0x007E/osr/README.md

  

# `OSR` - Output Shift Register Development Board

The `OSR` is a board with an [HEF4094B](#additional-information) or any other compatible shift-register that meets the pin requirements. The board itself can be driven from `5` to `15V`. The board offers the possibility to shift serial signals to a parallel output clocked by buttons or an external signal from any other logic board.

| Experience  | Level |
|:---|:---:|
| Soldering | ?% |

# Downloads

| Type | File | Description |
|:---:|:---:|:---|
| Schematic | [pdf](https://github.com/0x007E/osr/releases/latest/download/schematic.pdf) / [cadlab](https://cadlab.io/project/30669/main/files) | Schematic files |
| Board | [pdf](https://github.com/0x007E/osr/releases/latest/download/pcb.pdf) / [cadlab](https://cadlab.io/project/30669/main/files) | Board file |
| Drill | [pdf](https://github.com/0x007E/osr/releases/latest/download/drill.pdf) | Drill file |
| BoM | [xlsx](https://github.com/0x007E/osr/releases/latest/download/bom.xlsx) / [html](https://github.com/0x007E/osr/releases/latest/download/bom.html) | Bill of Material as Excel/interactive HTML |
| PCB | [zip](https://github.com/0x007E/osr/releases/latest/download/kicad.zip) / [tar](https://github.com/0x007E/osr/releases/latest/download/kicad.tar.gz) | KiCAD/Gerber/BoM/Drill files |
| Mechanical | [zip](https://github.com/0x007E/osr/releases/latest/download/freecad.zip) / [tar](https://github.com/0x007E/osr/releases/latest/download/freecad.tar.gz) | FreeCAD/Housing and PCB (STEP/STL) files |

# Hardware

The pcb is created with `KiCAD`. All files are built with `github actions` so that they are ready for a production environment.

## PCB

The circuit board is populated on both sides (Top, Bottom). The best way for soldering the `SMD` components is within a vapor phase soldering system and for the `THT` components with a standard soldering system.

### Top Layer

Top Layer

### Bottom Layer

Bottom Layer

# Additional Information

| Type | Link | Description |
|:---:|:---:|:---|
| HEF4094B | [pdf](https://assets.nexperia.com/documents/data-sheet/HEF4094B.pdf) | 8-stage shift-and-store register |

---

R. GAECHTER
