0x007E/osr/pcb/OSR.kicad_pcb

## KiCad design pcb/OSR.kicad_pcb (2026-11-05)

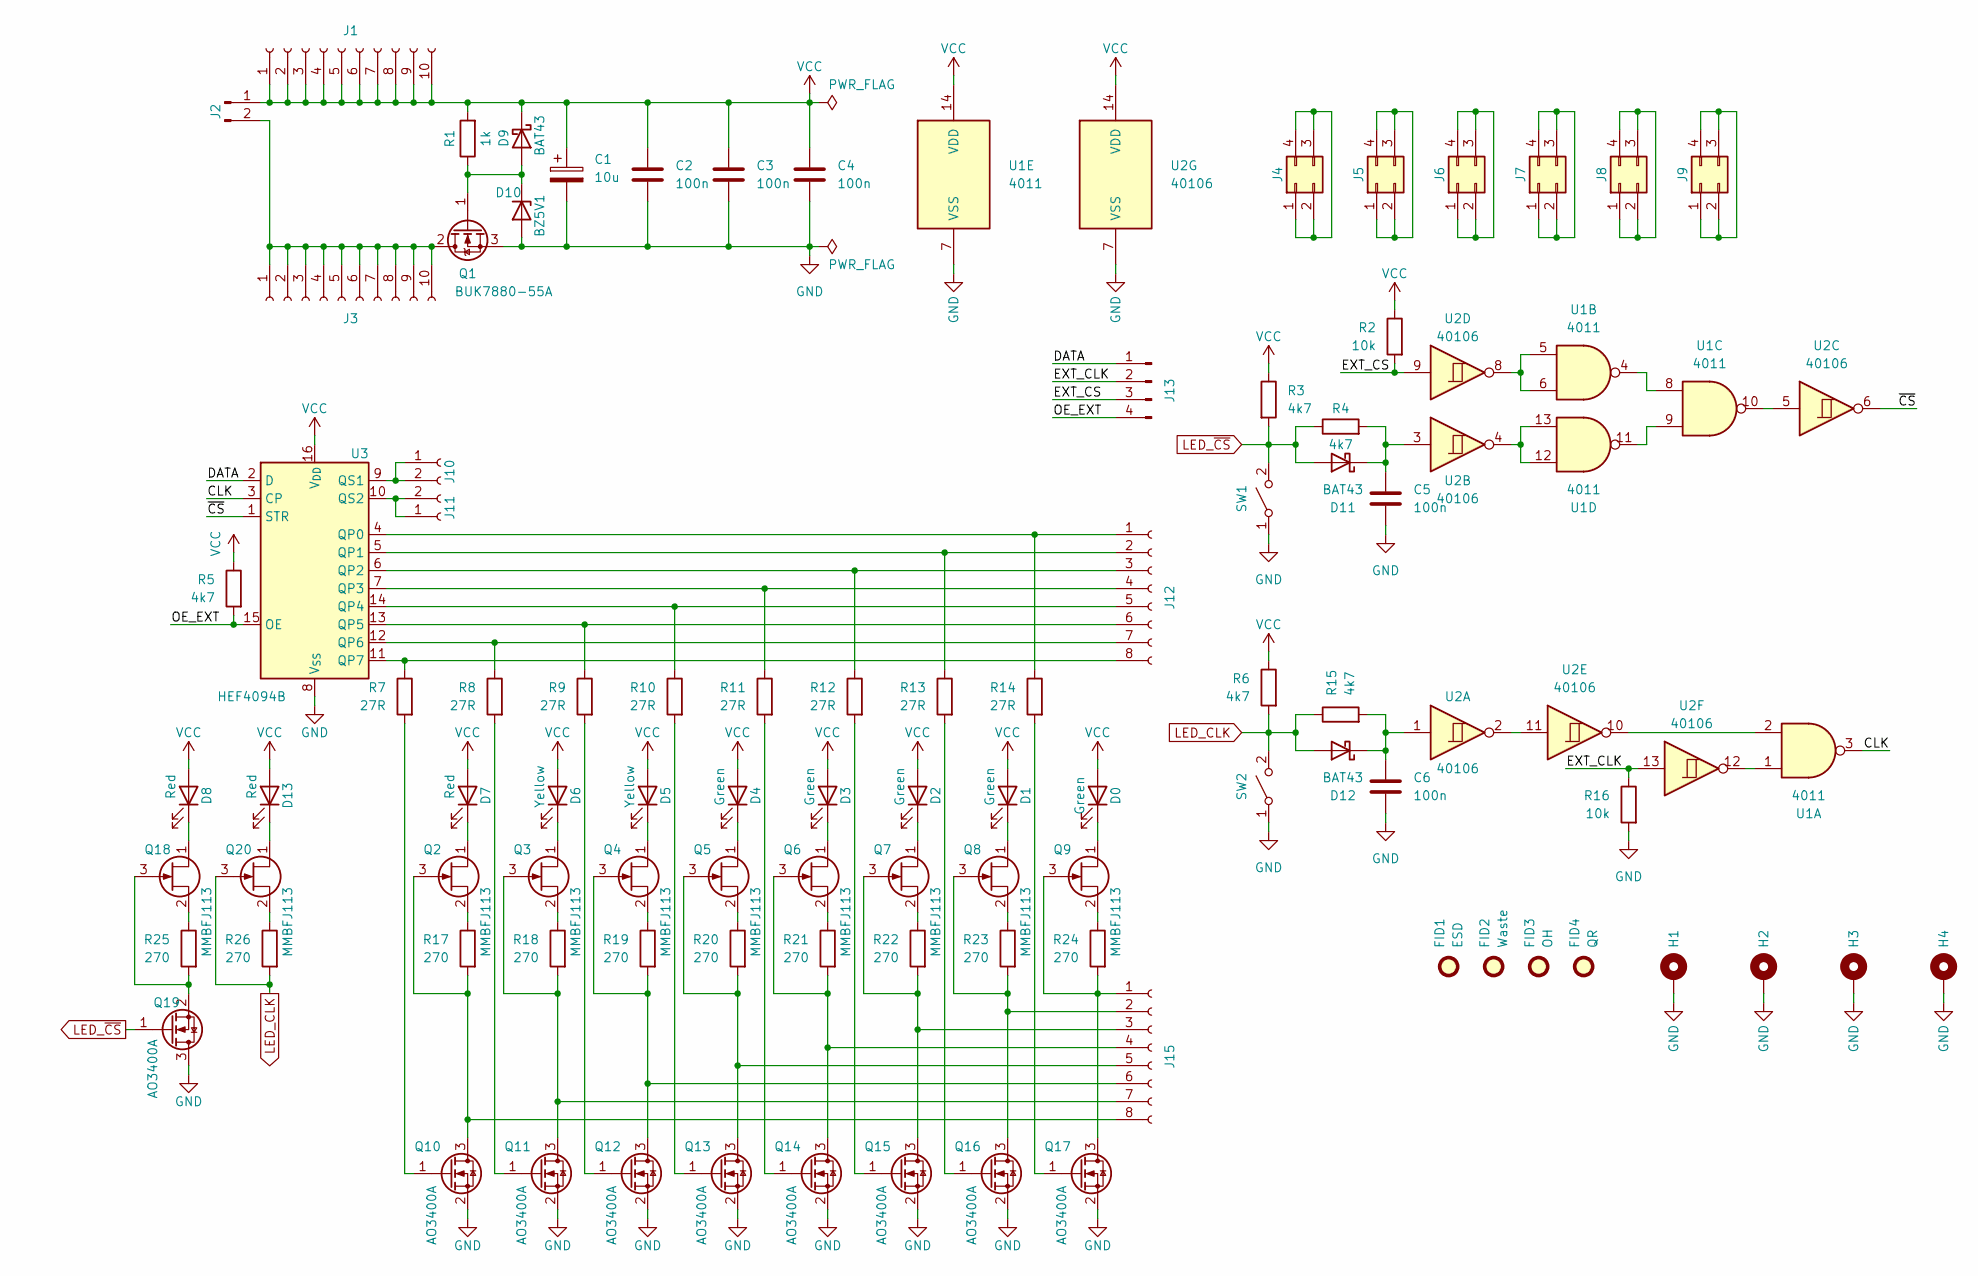
[picture p1: schematic OSR.kicad_sch, ${acronym} - ${title}]

Parts:
C1: 10u; CP_Radial_D6.3mm_P2.50mm
C2, C3, C4, C5, C6: 100n; C_1206_3216Metric
D0, D1, D2, D3, D4: Green; LED_1206_3216Metric
D5, D6: Yellow; LED_1206_3216Metric
D7, D8, D13: Red; LED_1206_3216Metric
D9, D11, D12: BAT43; D_MiniMELF
D10: BZ5V1; D_MiniMELF
FID1: ESD; ESD-Logo_6.6x6mm_SilkScreen
FID2: Waste; WEEE-Logo_4.2x6mm_SilkScreen
FID3: OH; OSHW-Logo_5.7x6mm_SilkScreen
FID4: QR; QR_0x007e
H1, H2, H3, H4: MountingHole_Pad; MountingHole_3.2mm_M3_Pad
J1, J3: Conn_01x10_Socket; PinSocket_1x10_P2.54mm_Vertical; DigiKey 2057-RS1-10-G-ND
J2: Conn_01x02_Pin; PinHeader_1x02_P2.54mm_Vertical
J4, J5, J6, J7, J8, J9: Conn_02x02_Counter_Clockwise; PinSocket_2x02_P2.54mm_Vertical; DigiKey 2057-RS2-04-G-ND
J10, J11: Conn_01x02_Socket; PinSocket_1x02_P2.54mm_Vertical; DigiKey 2057-RS1-02-G-ND
J12, J15: Conn_01x08_Socket; PinSocket_1x08_P2.54mm_Vertical; DigiKey 2057-RS1-08-G-ND
J13: Conn_01x04_Pin; PinHeader_1x04_P2.54mm_Vertical
Q1: BUK7880-55A; SOT-223-3_TabPin2
Q2, Q3, Q4, Q5, Q6, Q7, Q8, Q9, Q18, Q20: MMBFJ113; SOT-23; DigiKey MMBFJ113CT-ND
Q10, Q11, Q12, Q13, Q14, Q15, Q16, Q17, Q19: AO3400A; SOT-23-3
R1: 1k; R_1206_3216Metric
R2, R16: 10k; R_1206_3216Metric
R3, R4, R5, R6, R15: 4k7; R_1206_3216Metric
R7, R8, R9, R10, R11, R12, R13, R14: 27R; R_1206_3216Metric
R17, R18, R19, R20, R21, R22, R23, R24, R25, R26: 270; R_1206_3216Metric
SW1, SW2: SW_SPST; SW_SPST_PTS645
U1: 4011; SOIC-14_3.9x8.7mm_P1.27mm
U2: 40106; SOIC-14_3.9x8.7mm_P1.27mm; DigiKey 296-14081-1-ND
U3: HEF4094B; SOIC-16_3.9x9.9mm_P1.27mm; DigiKey 1727-3062-1-ND

Connections:
/CLK: U1.3, U3.3 (CP)
/DATA: J13.1, U3.2 (D)
/EXT_CLK: J13.2, R16.1, U2.13
/EXT_CS: J13.3, R2.2, U2.9
/OE_EXT: J13.4, R5.2, U3.15 (OE)
/~CS: U2.6, U3.1 (STR)
GND: C1.2, C2.2, C3.2, C4.2, C5.2, C6.2, D10.2 (A), H1.1, H2.1, H3.1, H4.1, Q1.3 (S), Q10.2 (S), Q11.2 (S), Q12.2 (S), Q13.2 (S), Q14.2 (S), Q15.2 (S), Q16.2 (S), Q17.2 (S), Q19.3 (D), R16.2, SW1.1 (A), SW2.1 (A), U1.7 (VSS), U2.7 (VSS), U3.8 (V_{SS})
LED_CLK: D12.2 (A), Q20.3 (G), R6.2, R15.1, R26.2, SW2.2 (B)
LED_~CS: D11.2 (A), Q19.1 (G), R3.2, R4.1, SW1.2 (B)
unnamed: D0.1 (K), Q9.1 (D)
unnamed: D1.1 (K), Q8.1 (D)
unnamed: D2.1 (K), Q7.1 (D)
unnamed: D3.1 (K), Q6.1 (D)
unnamed: D4.1 (K), Q5.1 (D)
unnamed: D5.1 (K), Q4.1 (D)
unnamed: D6.1 (K), Q3.1 (D)
unnamed: D7.1 (K), Q2.1 (D)
unnamed: D8.1 (K), Q18.1 (D)
unnamed: D9.2 (A), D10.1 (K), Q1.1 (G), R1.1
unnamed: C5.1, D11.1 (K), R4.2, U2.3
unnamed: C6.1, D12.1 (K), R15.2, U2.1
unnamed: D13.1 (K), Q20.1 (D)
unnamed: J2.2, J3.1, J3.2, J3.3, J3.4, J3.5, J3.6, J3.7, J3.8, J3.9, J3.10, Q1.2 (D)
unnamed: J4.1, J4.2, J4.3, J4.4
unnamed: J5.1, J5.2, J5.3, J5.4
unnamed: J6.1, J6.2, J6.3, J6.4
unnamed: J7.1, J7.2, J7.3, J7.4
unnamed: J8.1, J8.2, J8.3, J8.4
unnamed: J9.1, J9.2, J9.3, J9.4
unnamed: J10.1, J10.2, U3.9 (QS1)
unnamed: J11.1, J11.2, U3.10 (QS2)
unnamed: J12.1, R14.1, U3.4 (QP0)
unnamed: J12.2, R13.1, U3.5 (QP1)
unnamed: J12.3, R12.1, U3.6 (QP2)
unnamed: J12.4, R11.1, U3.7 (QP3)
unnamed: J12.5, R10.1, U3.14 (QP4)
unnamed: J12.6, R9.1, U3.13 (QP5)
unnamed: J12.7, R8.1, U3.12 (QP6)
unnamed: J12.8, R7.1, U3.11 (QP7)
unnamed: J15.1, Q9.3 (G), Q17.3 (D), R24.2
unnamed: J15.2, Q8.3 (G), Q16.3 (D), R23.2
unnamed: J15.3, Q7.3 (G), Q15.3 (D), R22.2
unnamed: J15.4, Q6.3 (G), Q14.3 (D), R21.2
unnamed: J15.5, Q5.3 (G), Q13.3 (D), R20.2
unnamed: J15.6, Q4.3 (G), Q12.3 (D), R19.2
unnamed: J15.7, Q3.3 (G), Q11.3 (D), R18.2
unnamed: J15.8, Q2.3 (G), Q10.3 (D), R17.2
unnamed: Q2.2 (S), R17.1
unnamed: Q3.2 (S), R18.1
unnamed: Q4.2 (S), R19.1
unnamed: Q5.2 (S), R20.1
unnamed: Q6.2 (S), R21.1
unnamed: Q7.2 (S), R22.1
unnamed: Q8.2 (S), R23.1
unnamed: Q9.2 (S), R24.1
unnamed: Q10.1 (G), R7.2
unnamed: Q11.1 (G), R8.2
unnamed: Q12.1 (G), R9.2
unnamed: Q13.1 (G), R10.2
unnamed: Q14.1 (G), R11.2
unnamed: Q15.1 (G), R12.2
unnamed: Q16.1 (G), R13.2
unnamed: Q17.1 (G), R14.2
unnamed: Q18.3 (G), Q19.2 (S), R25.2
unnamed: Q18.2 (S), R25.1
unnamed: Q20.2 (S), R26.1
unnamed: U1.1, U2.12
unnamed: U1.2, U2.10
unnamed: U1.4, U1.8
unnamed: U1.5, U1.6, U2.8
unnamed: U1.10, U2.5
unnamed: U1.9, U1.11
unnamed: U1.12, U1.13, U2.4
unnamed: U2.2, U2.11
VCC: C1.1, C2.1, C3.1, C4.1, D0.2 (A), D1.2 (A), D2.2 (A), D3.2 (A), D4.2 (A), D5.2 (A), D6.2 (A), D7.2 (A), D8.2 (A), D9.1 (K), D13.2 (A), J1.1, J1.2, J1.3, J1.4, J1.5, J1.6, J1.7, J1.8, J1.9, J1.10, J2.1, R1.2, R2.1, R3.1, R5.1, R6.1, U1.14 (VDD), U2.14 (VDD), U3.16 (V_{DD})

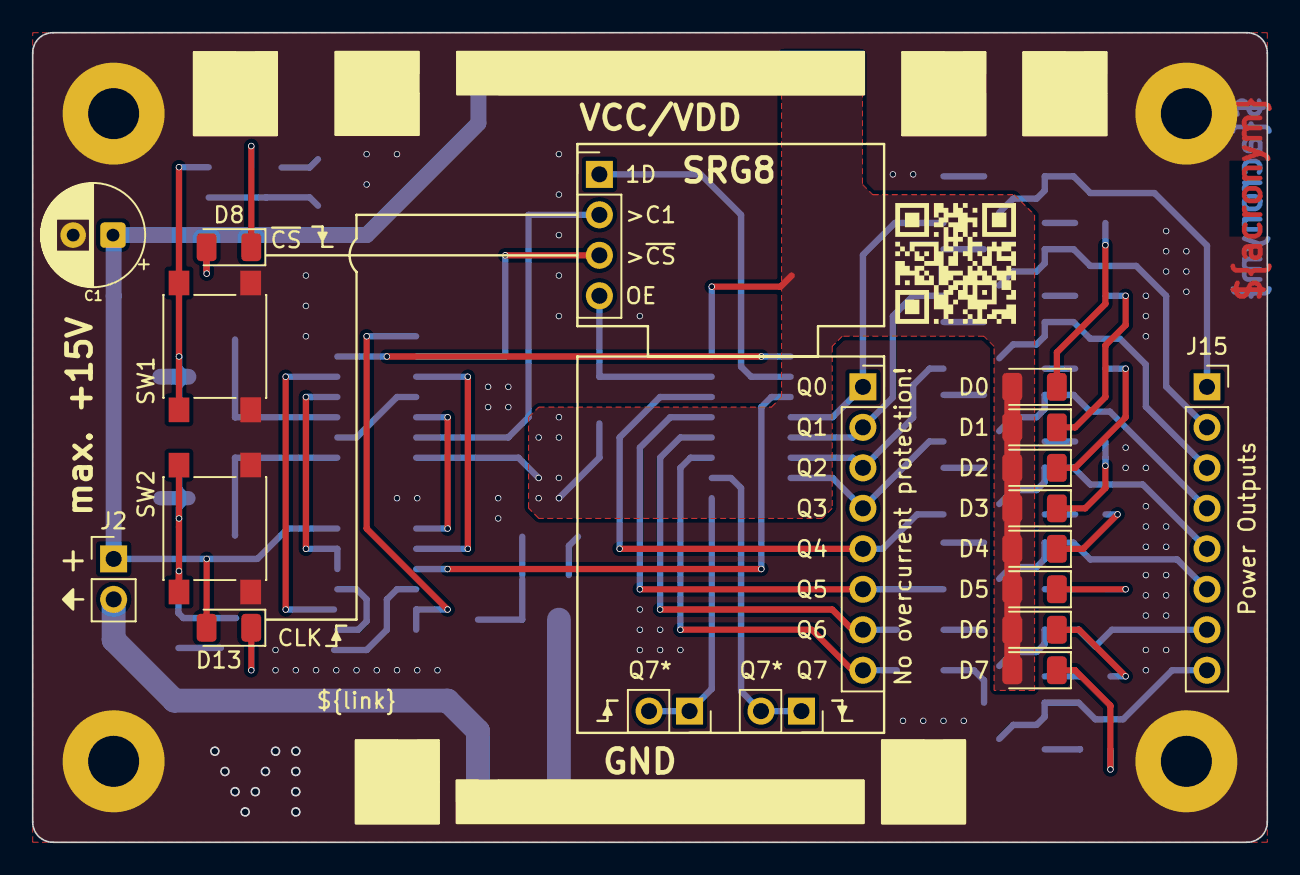
[picture p2: board OSR.kicad_pcb from above]

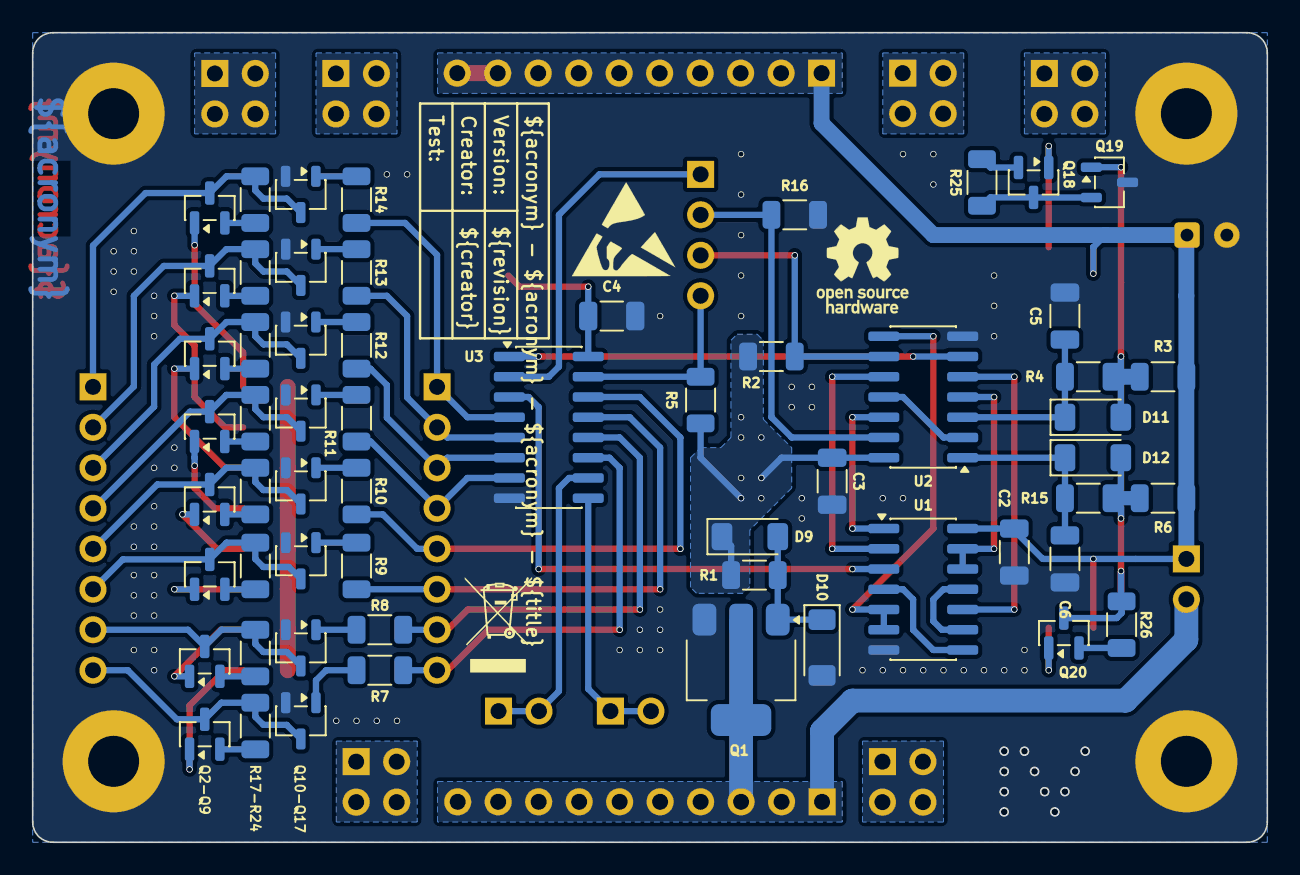
[picture p3: board OSR.kicad_pcb from below]

Board: 2 copper layers, 77.5 x 50.8 mm, 93 parts (61 on the bottom side), 75 nets.
