0x007E/osr/(commit log)

2026-10-26 Add pcb layout
    [SRB.kicad_pcb, SRB.kicad_sch]
2026-10-26 Add GND vias
    [SRB.kicad_pcb]
2026-10-26 Rename pcb project
    [OSR.kicad_pcb, OSR.kicad_sch]
2026-10-26 Add CLK and CS led beside push-button
    [OSR.kicad_pcb, OSR.kicad_sch]
2026-10-26 Add missing OE text to silkscreen
    [OSR.kicad_pcb]
2026-10-26 Fix project description
    [OSR.kicad_pcb]
2026-10-26 Rearrange fabrication layer
    [OSR.kicad_pcb]
2026-11-05 Fix incorrectly wired mosfets
    [OSR.kicad_pcb, OSR.kicad_sch]
